ssloy/nixie-clock/hardware/1+3-nixies/Readme.md

# beware of bugs

Some tracks are missing in the PCB layout (the schematics are fine).

The single nixie module lacks two tracks:

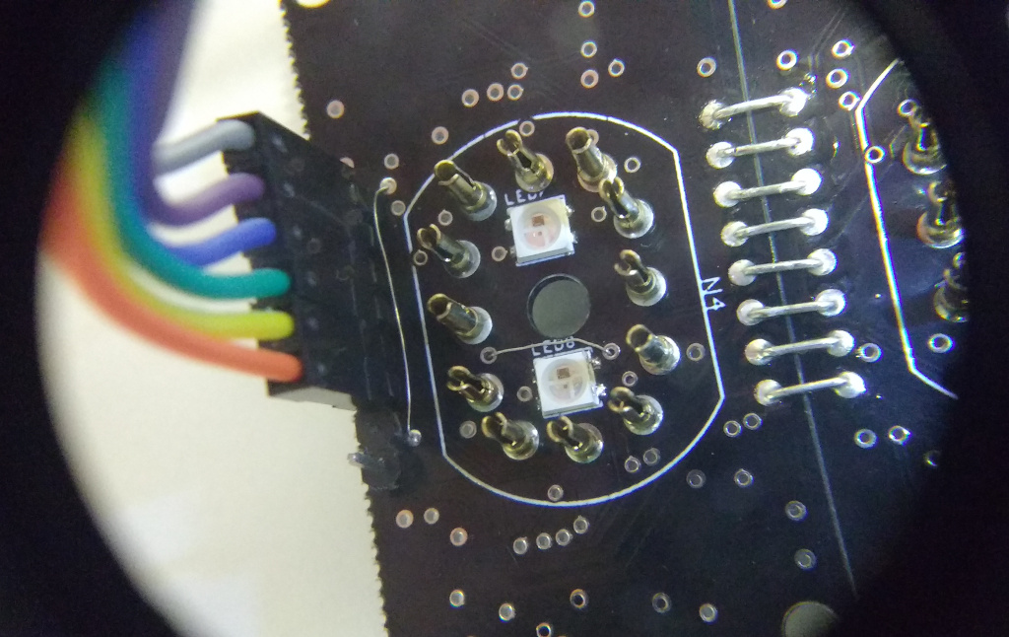
[picture p1: hardware/1+3-nixies/bugfix-1.jpg]


The triple nixie module lacks one track:

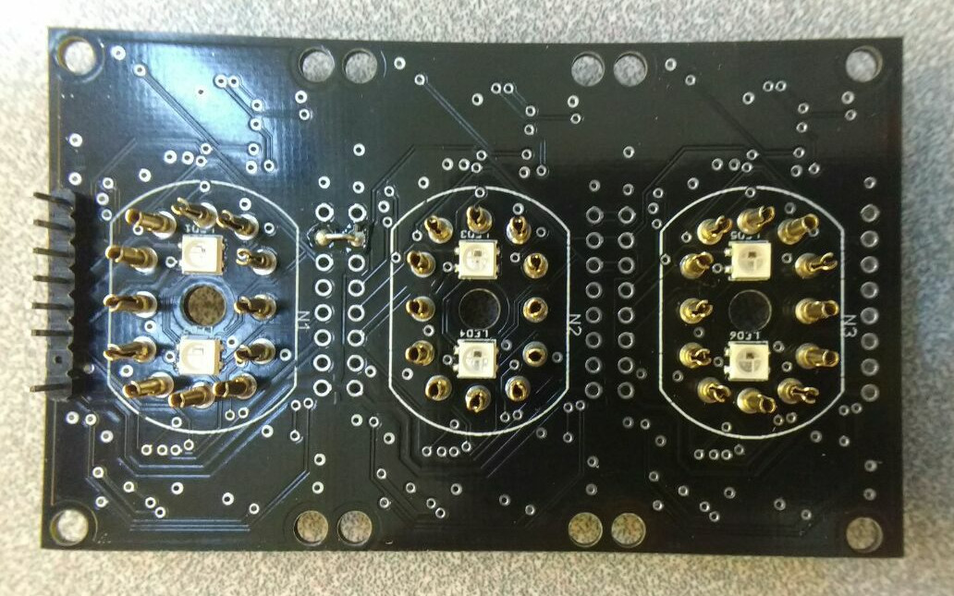
[picture p2: hardware/1+3-nixies/bugfix-3.jpg]
