ssloy/nixie-clock/hardware/ИН12-А(Б).jpg

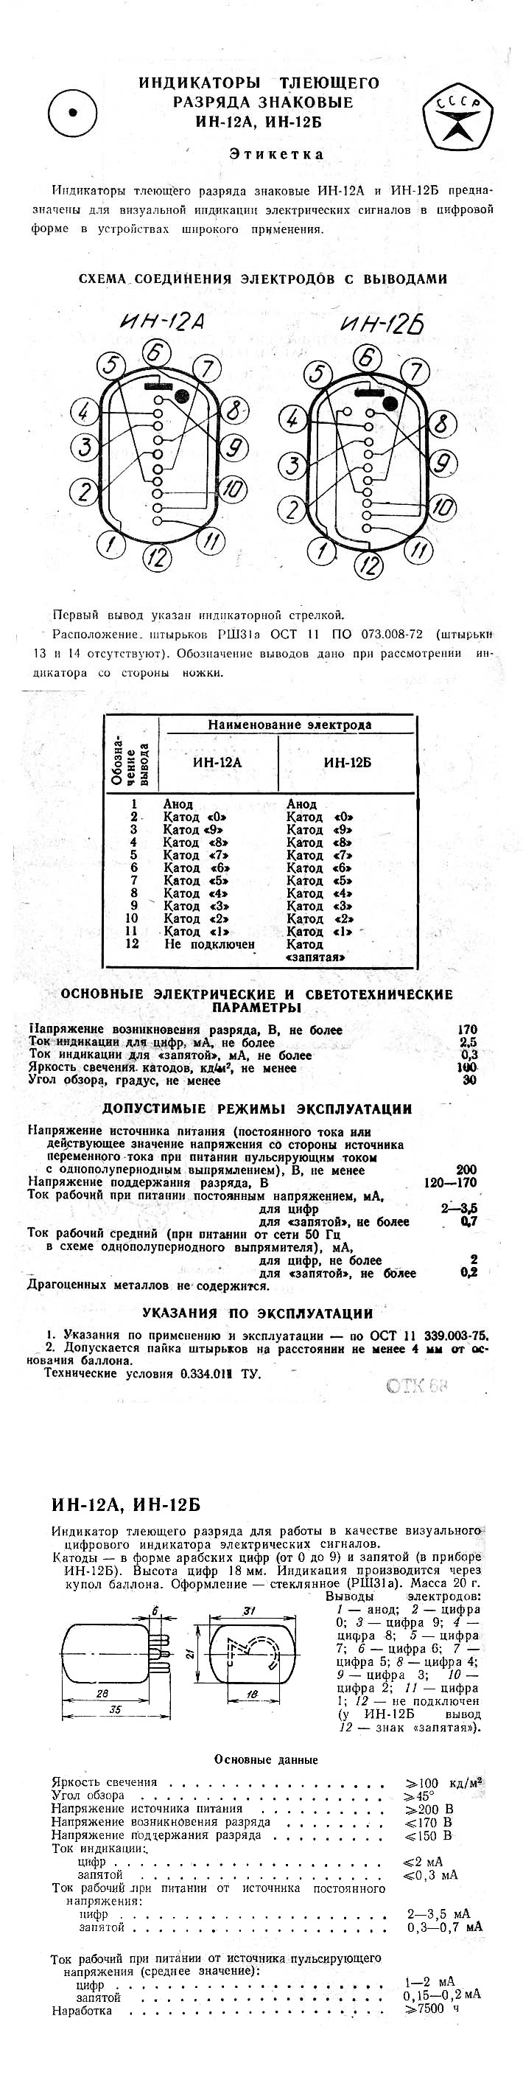
hardware/ИН12-А(Б).jpg
