ssloy/nixie-clock/hardware/ИН-15А(Б).jpg

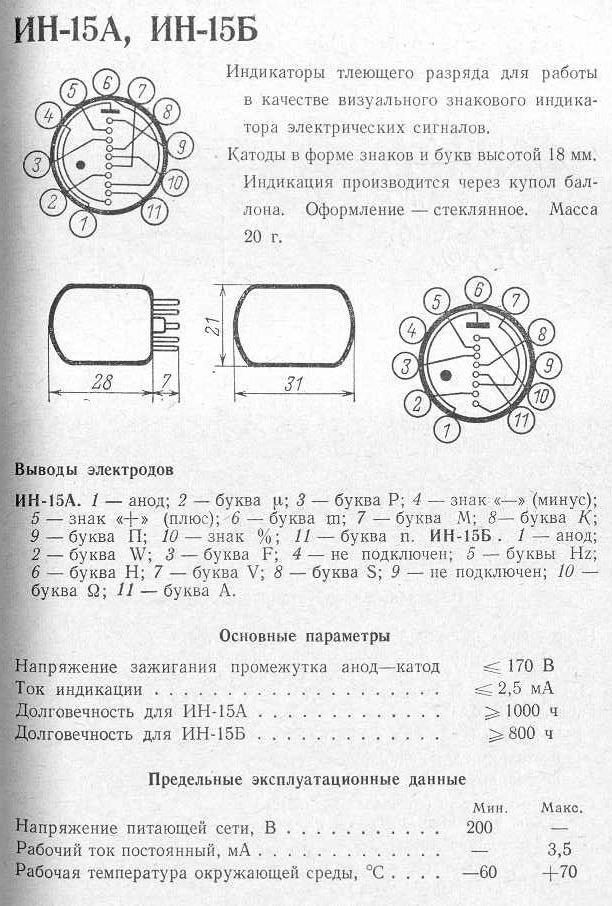
hardware/ИН-15А(Б).jpg
