ssloy/nixie-clock/hardware/ИНС-1.jpg

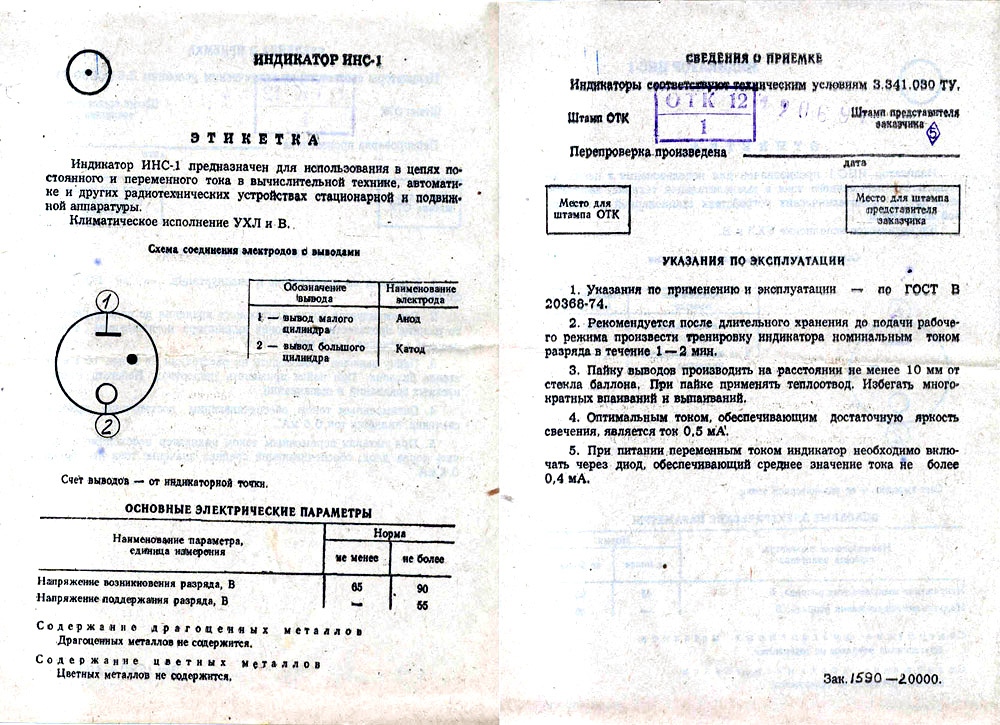
hardware/ИНС-1.jpg
