ssloy/nixie-clock/hardware/HV10W PSU/MC34063HV-02B-SMD.brd

## EAGLE design hardware/HV10W PSU/MC34063HV-02B-SMD.brd (2020-02-29)

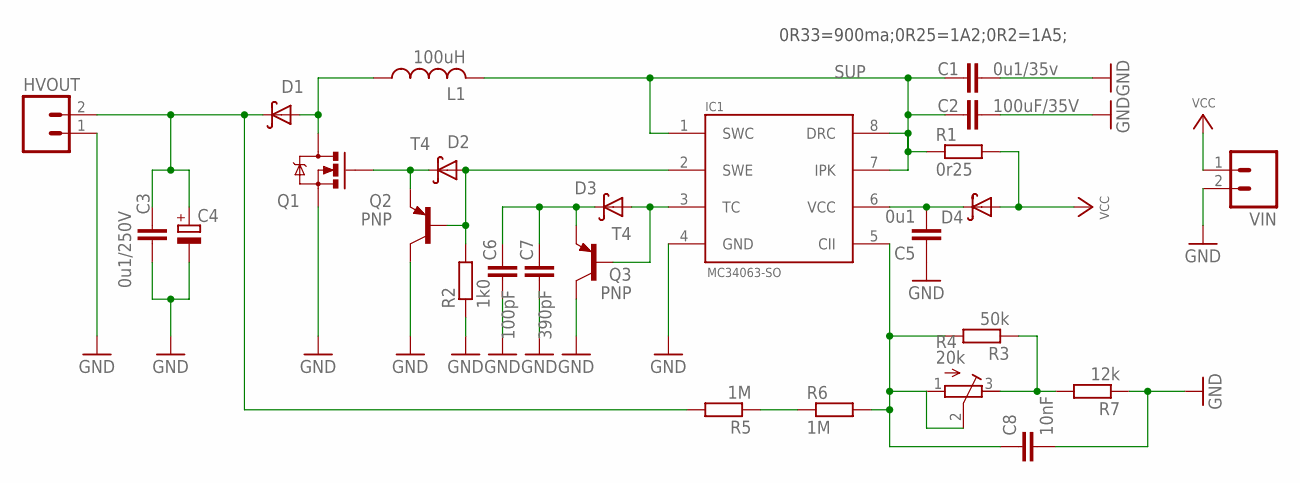
[picture p6: schematic MC34063HV-02B-SMD.sch]

Parts:
C1: 0u1/35v; C1206
C2: 100uF/35V; C1206
C3: 0u1/250V; C1206K
C4: CPOL-EUE5-10.5; E5-10,5
C5: 0u1; C0603
C6: 100pF; C0603
C7: 390pF; C0603
C8: 10nF; C0603
D1, D4: DIODE-SCHOTTKYSMA; SMA-DIODE
D2: T4; SOD123
D3: T4; SOD323-W
HVOUT: M02PTH; 1X02
IC1: MC34063-SO; SO8
L1: 100uH; INDUCTOR11X11
Q1: MOSFET-NCHANNELTO220V-BH2; TO220V-BIGHOLE-V2
Q2, Q3: PNP; SOT23-BEC
R1: 0r25; R1206
R2: 1k0; R0603
R3: 50k; R0603
R4: 20k; RTRIM3296W
R5, R6: 1M; R1206
R7: 12k; R0603
VIN: M02PTH; 1X02

Connections:
GND: C1.2, C2.2, C3.2, C4.-, C5.1, C6.1, C7.1, C8.2, HVOUT.1, IC1.4 (GND), Q1.3 (S), Q2.3 (C), Q3.3 (C), R2.1, R7.1, VIN.2
HVFB: C8.1, IC1.5 (CII), R3.2, R4.1 (A), R4.2 (S), R6.2
unnamed: C6.2, C7.2, D3.C, Q3.2 (E)
unnamed: D2.A, IC1.2 (SWE), Q2.1 (B), R2.2
unnamed: D2.C, Q1.1 (G), Q2.2 (E)
unnamed: C5.2, D4.C, IC1.6 (VCC)
unnamed: C3.1, C4.+, D1.C, HVOUT.2, R5.2
unnamed: D3.A, IC1.3 (TC), Q3.1 (B)
unnamed: R5.1, R6.1
unnamed: R3.1, R4.3 (E), R7.2
SUP: C1.1, C2.1, IC1.1 (SWC), IC1.7 (IPK), IC1.8 (DRC), L1.P$2 (2), R1.1
SW: D1.A, L1.P$1 (1), Q1.2 (D)
VCC: D4.A, R1.2, VIN.1

Notes on the sheet:
0R33=900ma;0R25=1A2;0R2=1A5;

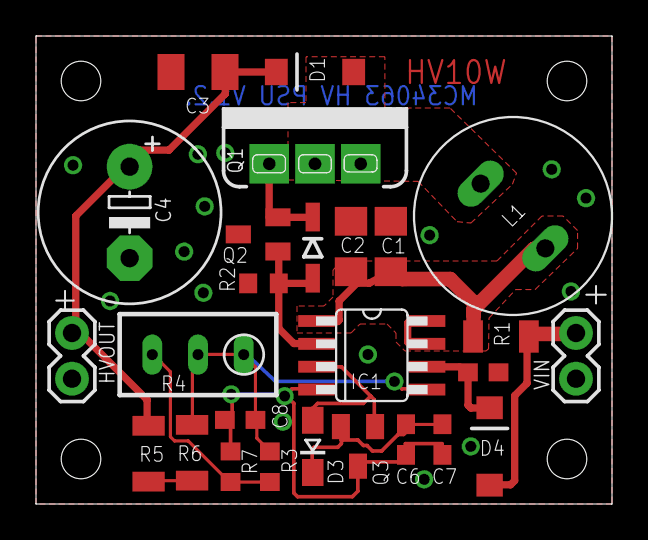
[picture p7: board MC34063HV-02B-SMD.brd from above]

Board: 2 copper layers, 32.0 x 26.0 mm, 27 parts (1 on the bottom side), 13 nets.

Other parts of the board:
U$1: HV03
