ssloy/nixie-clock/hardware/2-nixies/DualNixie.brd

## EAGLE design hardware/2-nixies/DualNixie.brd (2020-02-22)

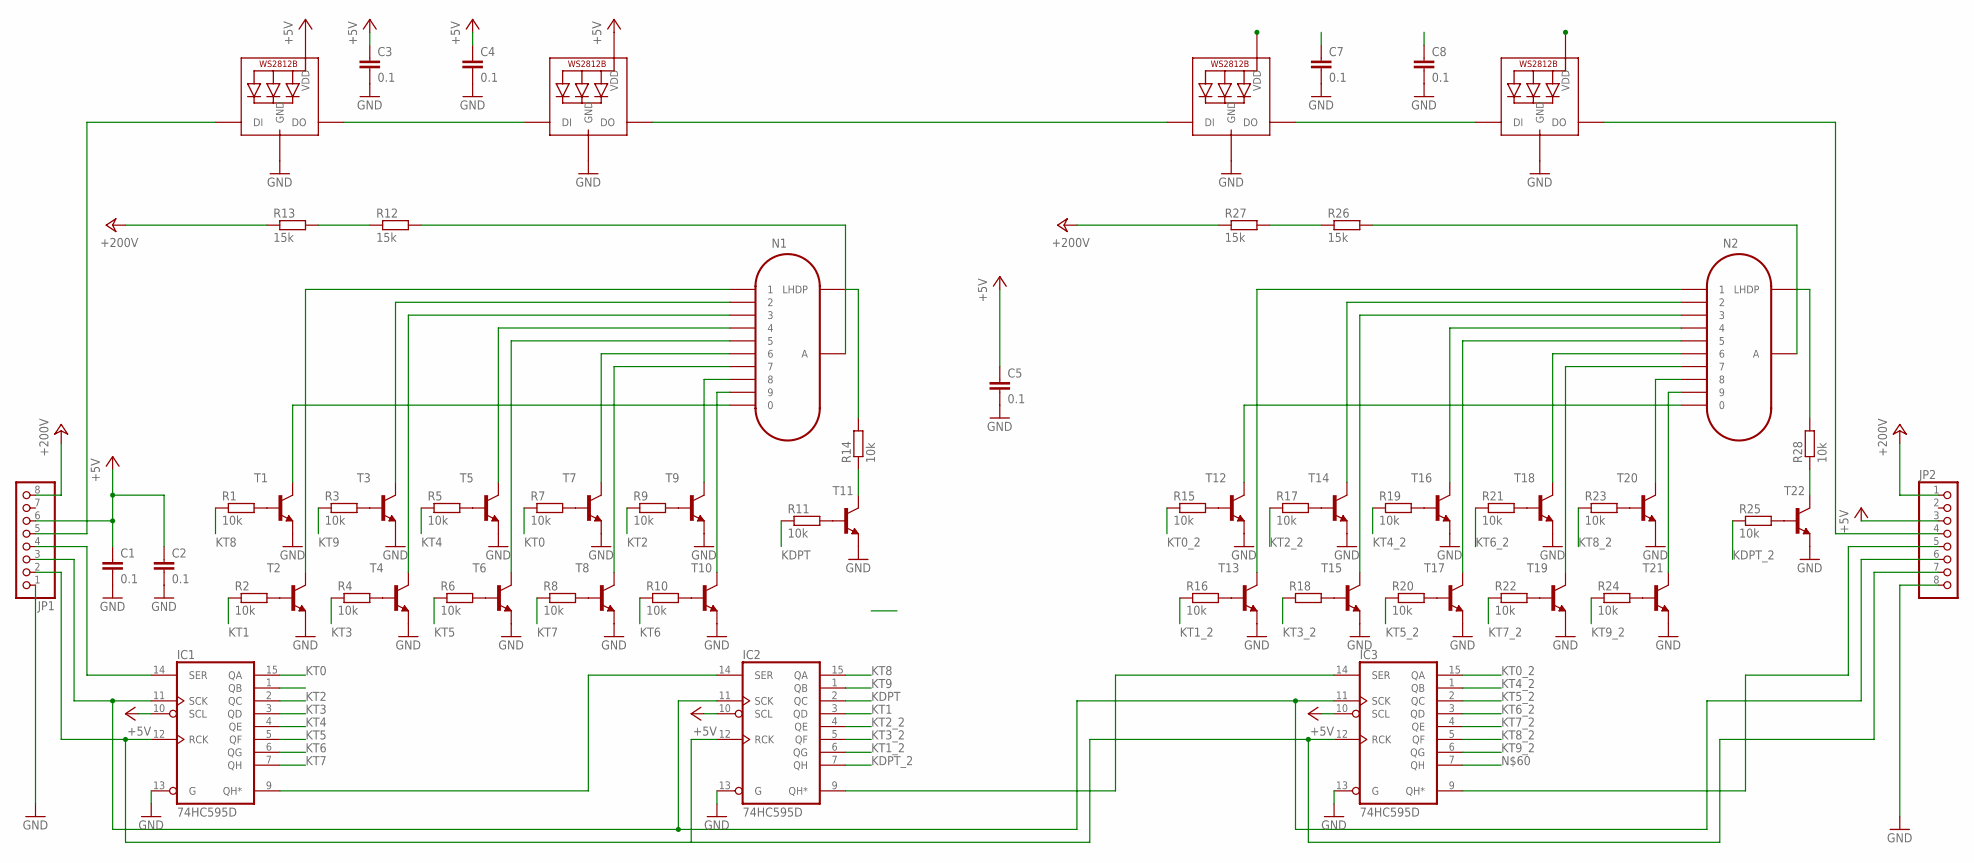
[picture p8: schematic DualNixie.sch]

Parts:
C1, C2, C3, C4, C5, C7, C8: 0.1; C0805
IC1, IC2, IC3: 74HC595D; SO16
JP1, JP2: HEADER-1X8ROUND; 1X08_ROUND
LED1, LED2, LED3, LED4: WS2812B3535; LED3535
N1, N2: IN-12B1.5MM; IN-12-1.5
R1, R2, R3, R4, R5, R6, R7, R8, R9, R10, R11, R14, R15, R16, R17, R18, R19, R20, R21, R22, R23, R24, R25, R28: 10k; R0805
R12, R13, R26, R27: 15k; R0805
T1, T2, T3, T4, T5, T6, T7, T8, T9, T10, T11, T12, T13, T14, T15, T16, T17, T18, T19, T20, T21, T22: MMBTA42LT1-NPN-SOT23-BEC; SOT23-BEC

Connections:
+5V: C1.1, C2.1, C3.1, C4.1, C5.1, C7.1, C8.1, IC1.10 (SCL), IC1.16 (VCC), IC2.10 (SCL), IC2.16 (VCC), IC3.10 (SCL), IC3.16 (VCC), JP1.6, JP2.3, LED1.2 (VDD), LED2.2 (VDD), LED3.2 (VDD), LED4.2 (VDD)
+200V: JP1.8, JP2.1, R13.1, R27.1
ANODE: N1.A, R12.2
ANODE1: N2.A, R26.2
GND: C1.2, C2.2, C3.2, C4.2, C5.2, C7.2, C8.2, IC1.8 (GND), IC1.13 (G), IC2.8 (GND), IC2.13 (G), IC3.8 (GND), IC3.13 (G), JP1.1, JP2.8, LED1.4 (GND), LED2.4 (GND), LED3.4 (GND), LED4.4 (GND), T1.E, T2.E, T3.E, T4.E, T5.E, T6.E, T7.E, T8.E, T9.E, T10.E, T11.E, T12.E, T13.E, T14.E, T15.E, T16.E, T17.E, T18.E, T19.E, T20.E, T21.E, T22.E
K0: N1.0, T1.C
K1: N1.1, T2.C
K2: N1.2, T3.C
K3: N1.3, T4.C
K4: N1.4, T5.C
K5: N1.5, T6.C
K6: N1.6, T7.C
K7: N1.7, T8.C
K8: N1.8, T9.C
K9: N1.9, T10.C
K10: N2.0, T12.C
K11: N2.1, T13.C
K12: N2.2, T14.C
K13: N2.3, T15.C
K14: N2.4, T16.C
K15: N2.5, T17.C
K16: N2.6, T18.C
K17: N2.7, T19.C
K18: N2.8, T20.C
K19: N2.9, T21.C
KDP: N1.LHDP, R14.2
KDP1: N2.LHDP, R28.2
KDPT: IC2.2 (QC), R11.1
KDPT_2: IC2.7 (QH), R25.1
KT0: IC1.15 (QA), R7.1
KT0_2: IC3.15 (QA), R15.1
KT1: IC2.3 (QD), R2.1
KT1_2: IC2.6 (QG), R16.1
KT2: IC1.2 (QC), R9.1
KT2_2: IC2.4 (QE), R17.1
KT3: IC1.3 (QD), R4.1
KT3_2: IC2.5 (QF), R18.1
KT4: IC1.4 (QE), R5.1
KT4_2: IC3.1 (QB), R19.1
KT5: IC1.5 (QF), R6.1
KT5_2: IC3.2 (QC), R20.1
KT6: IC1.6 (QG), R10.1
KT6_2: IC3.3 (QD), R21.1
KT7: IC1.7 (QH), R8.1
KT7_2: IC3.4 (QE), R22.1
KT8: IC2.15 (QA), R1.1
KT8_2: IC3.5 (QF), R23.1
KT9: IC2.1 (QB), R3.1
KT9_2: IC3.6 (QG), R24.1
unnamed: R3.2, T3.B
unnamed: R1.2, T1.B
unnamed: R2.2, T2.B
unnamed: R4.2, T4.B
unnamed: R5.2, T5.B
unnamed: R6.2, T6.B
unnamed: R7.2, T7.B
unnamed: R8.2, T8.B
unnamed: R9.2, T9.B
unnamed: R10.2, T10.B
unnamed: LED1.3 (DO), LED2.1 (DI)
unnamed: JP1.5, LED1.1 (DI)
unnamed: LED2.3 (DO), LED3.1 (DI)
unnamed: R15.2, T12.B
unnamed: R16.2, T13.B
unnamed: R17.2, T14.B
unnamed: R18.2, T15.B
unnamed: R19.2, T16.B
unnamed: R20.2, T17.B
unnamed: R21.2, T18.B
unnamed: R11.2, T11.B
unnamed: IC1.14 (SER), JP1.4
unnamed: R14.1, T11.C
unnamed: R12.1, R13.2
unnamed: IC1.9 (QH*), IC2.14 (SER)
unnamed: IC1.11 (SCK), IC2.11 (SCK), IC3.11 (SCK), JP1.3, JP2.6
unnamed: IC2.9 (QH*), IC3.14 (SER)
unnamed: R22.2, T19.B
unnamed: R23.2, T20.B
unnamed: R24.2, T21.B
unnamed: R25.2, T22.B
unnamed: R28.1, T22.C
unnamed: R26.1, R27.2
unnamed: IC1.12 (RCK), IC2.12 (RCK), IC3.12 (RCK), JP1.2, JP2.7
unnamed: IC3.9 (QH*), JP2.5
unnamed: LED3.3 (DO), LED4.1 (DI)
unnamed: JP2.4, LED4.3 (DO)

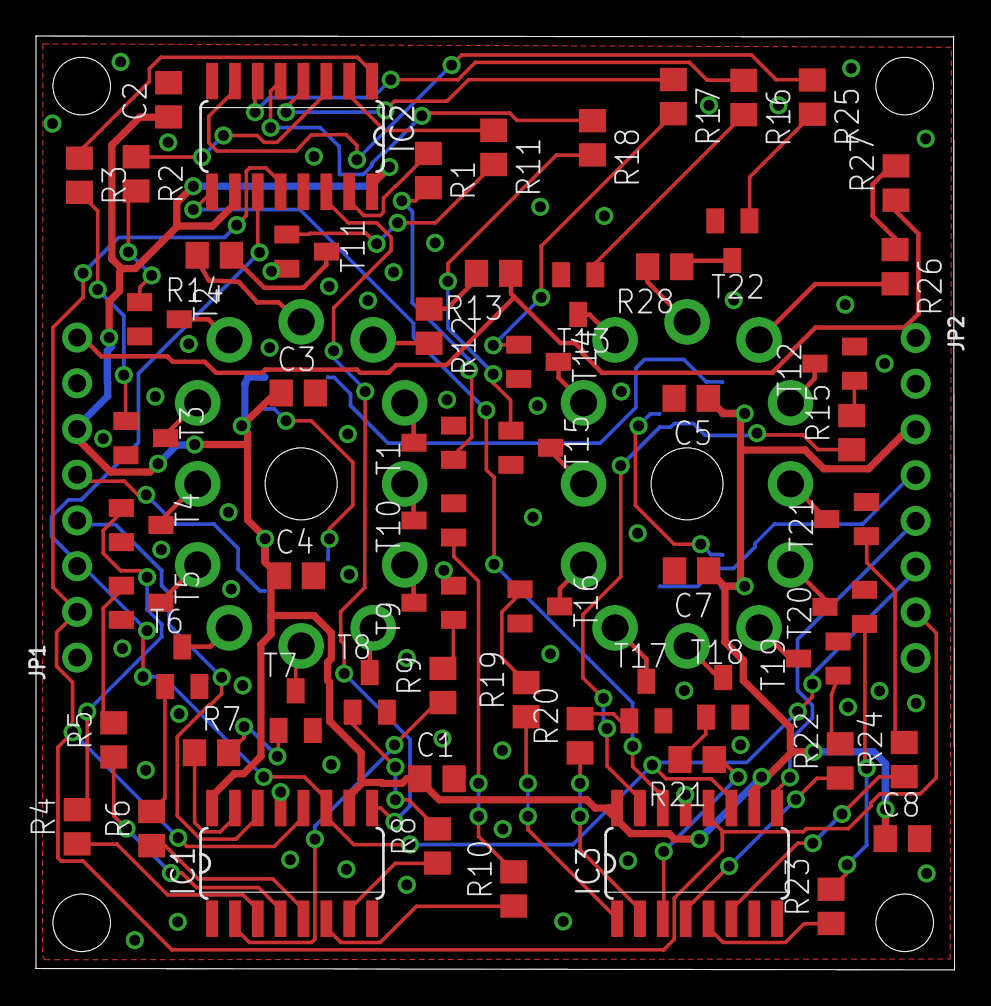
[picture p9: board DualNixie.brd from above]

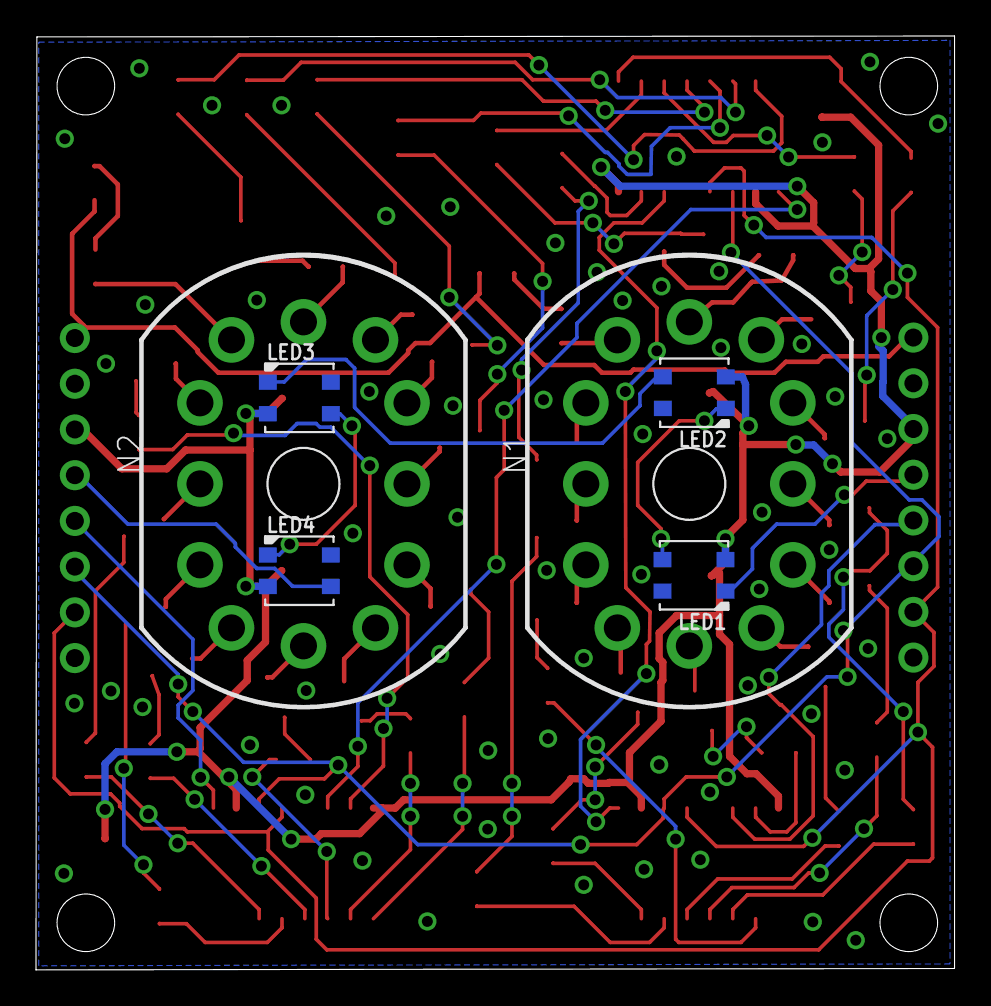
[picture p10: board DualNixie.brd from below]

Board: 2 copper layers, 51.0 x 51.9 mm, 68 parts (6 on the bottom side), 86 nets.
