ssloy/nixie-clock/hardware/1+3-nixies/MultipleNixie.brd

## EAGLE design hardware/1+3-nixies/MultipleNixie.brd (2020-02-29)

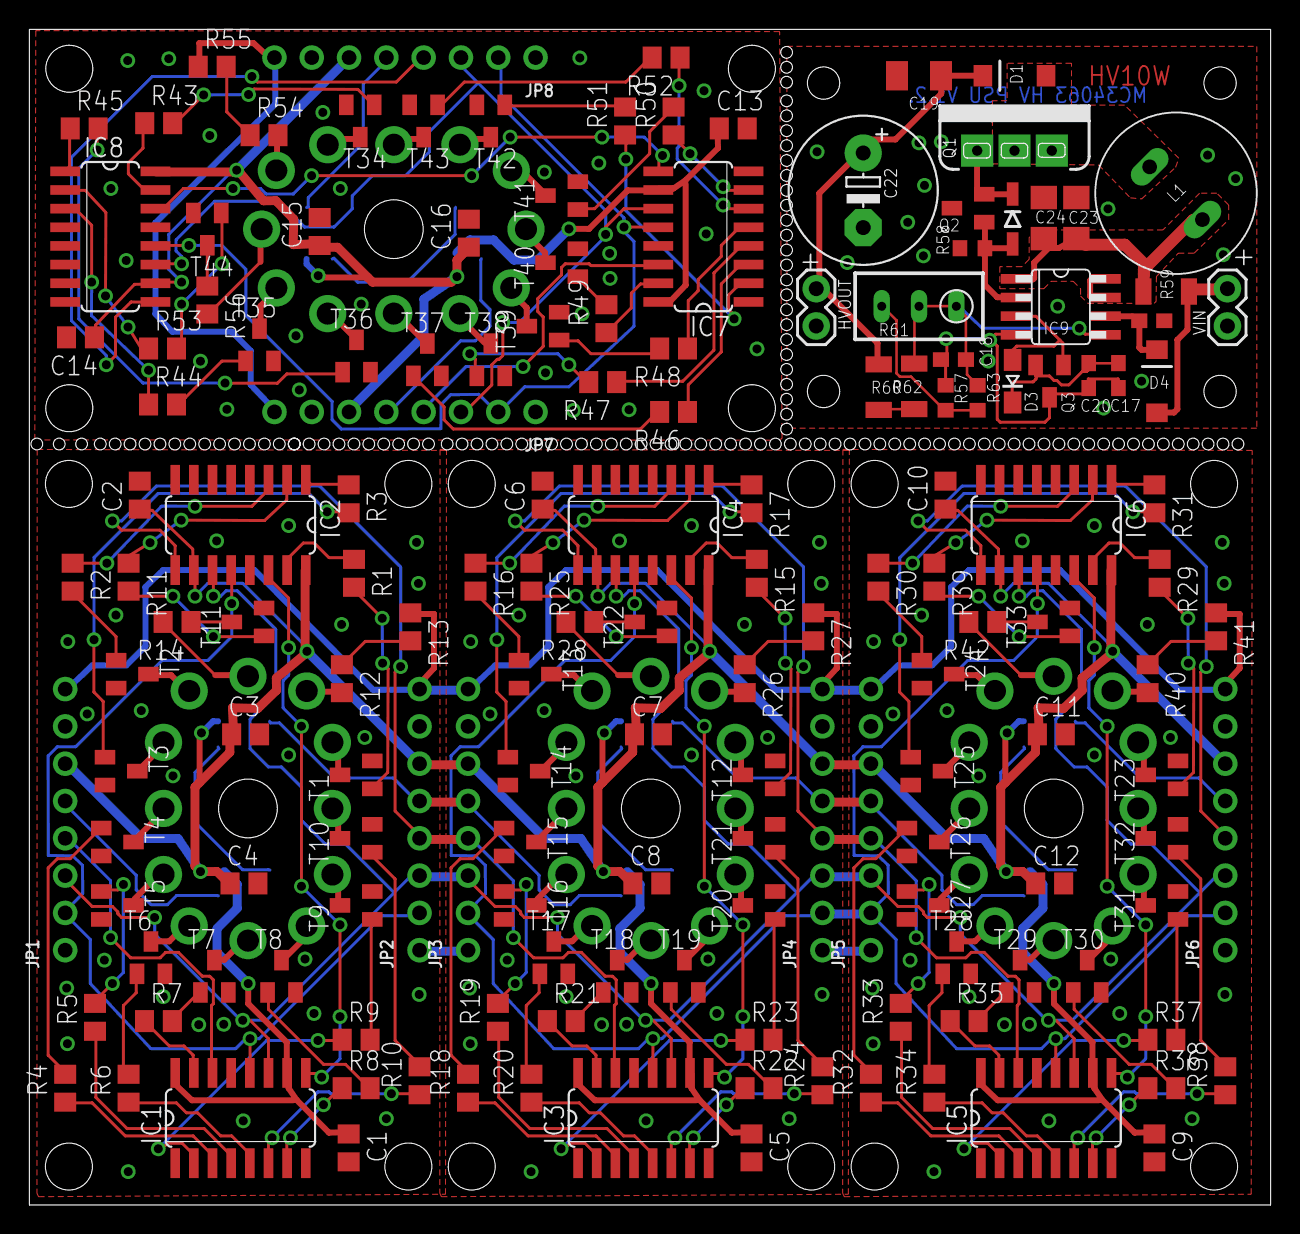
[picture p11: board MultipleNixie.brd from above]

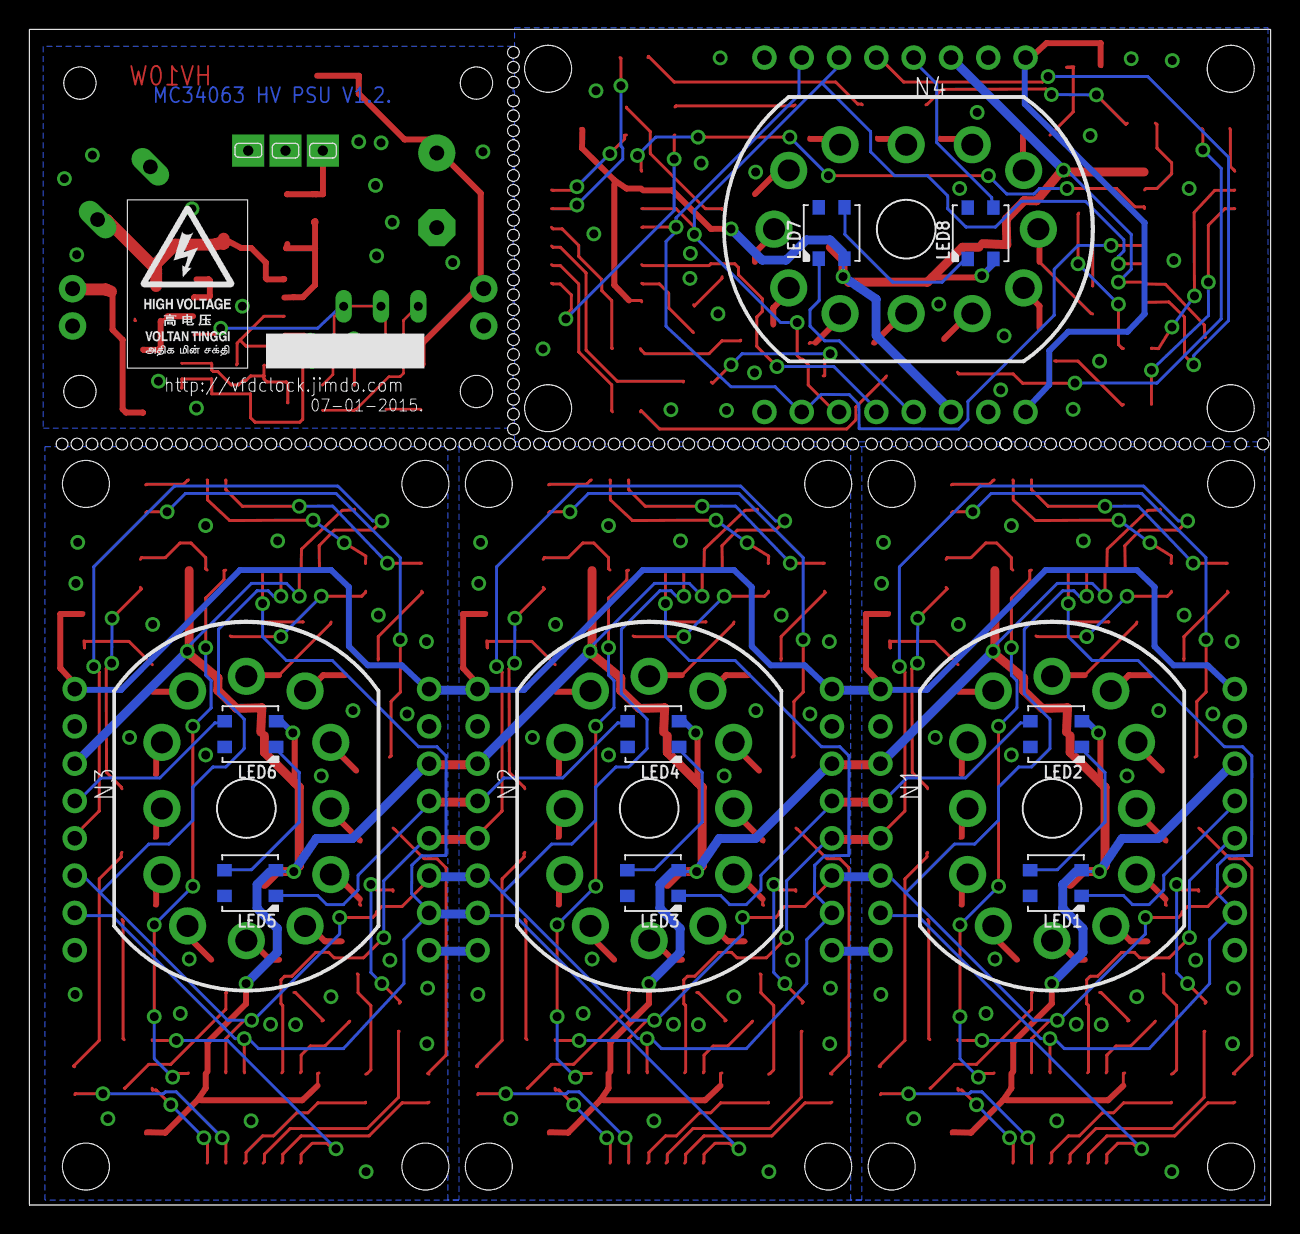
[picture p12: board MultipleNixie.brd from below]

Board: 2 copper layers, 84.5 x 80.1 mm, 171 parts (13 on the bottom side), 199 nets.

Parts:
C1, C2, C3, C4, C5, C6, C7, C8, C9, C10, C11, C12, C13, C14, C15, C16: 0.1; C0805
C17: 390pF; C0603
C18: 10nF; C0603
C19: 0u1/250V; C1206K
C20: 100pF; C0603
C21: 0u1; C0603
C22: E5-10,5
C23: 0u1/35v; C1206
C24: 100uF/35V; C1206
D1: DIODE-SCHOTTKYSMA; SMA-DIODE
D2: T4; SOD123
D3: T4; SOD323-W
D4: SMA-DIODE
HVOUT: 1X02
IC1, IC2, IC3, IC4, IC5, IC6, IC7, IC8: 74HC595D; SO16
IC9: MC34063-SO; SO8
JP1, JP2, JP3, JP4, JP5, JP6, JP7, JP8: 1X08_ROUND
L1: 100uH; INDUCTOR11X11
LED1, LED2, LED3, LED4, LED5, LED6, LED7, LED8: WS2812B3535; LED3535
N1, N2, N3, N4: IN-12B1.5MM; IN-12-1.5
Q1: TO220V-BIGHOLE-V2
Q2, Q3: PNP; SOT23-BEC
R1, R2, R3, R4, R5, R6, R7, R8, R9, R10, R11, R14, R15, R16, R17, R18, R19, R20, R21, R22, R23, R24, R25, R28, R29, R30, R31, R32, R33, R34, R35, R36, R37, R38, R39, R42, R43, R44, R45, R46, R47, R48, R49, R50, R51, R52, R53, R56: 10k; R0805
R12, R13, R26, R27, R40, R41, R54, R55: 15k; R0805
R57: 12k; R0603
R58: 1k0; R0603
R59: 0r25; R1206
R60, R62: 1M; R1206
R61: 20k; RTRIM3296W
R63: 50k; R0603
T1, T2, T3, T4, T5, T6, T7, T8, T9, T10, T11, T12, T13, T14, T15, T16, T17, T18, T19, T20, T21, T22, T23, T24, T25, T26, T27, T28, T29, T30, T31, T32, T33, T34, T35, T36, T37, T38, T39, T40, T41, T42, T43, T44: SOT23-BEC
U$1: HV03
VIN: 1X02

Connections:
+5V: C1.1, C2.1, C3.1, C4.1, IC1.10, IC1.16, IC2.10, IC2.16, JP1.6, JP2.6, LED1.2, LED2.2
+5V1: C5.1, C6.1, C7.1, C8.1, IC3.10, IC3.16, IC4.10, IC4.16, JP3.6, JP4.6, LED3.2, LED4.2
+5V2: C9.1, C10.1, C11.1, C12.1, IC5.10, IC5.16, IC6.10, IC6.16, JP5.6, JP6.6, LED5.2, LED6.2
+5V3: C13.1, C14.1, C15.1, C16.1, IC7.10, IC7.16, IC8.10, IC8.16, JP7.6, JP8.6, LED7.2, LED8.2
+200V: JP1.8, JP2.8, R13.1
+200V1: JP3.8, JP4.8, R27.1
+200V2: JP5.8, JP6.8, R41.1
+200V3: JP7.8, JP8.8, R55.1
ANODE: N1.A, R12.2
ANODE1: N2.A, R26.2
ANODE2: N3.A, R40.2
ANODE3: N4.A, R54.2
GND: C1.2, C2.2, C3.2, C4.2, C5.2, C6.2, C7.2, C8.2, C9.2, C10.2, C11.2, C12.2, IC1.8, IC1.13, IC2.8, IC2.13, IC3.8, IC3.13, IC4.8, IC4.13, IC5.8, IC5.13, IC6.8, IC6.13, JP1.1, JP2.1, JP3.1, JP4.1, JP5.1, JP6.1, LED1.4, LED2.4, LED3.4, LED4.4, LED5.4, LED6.4, T1.E, T2.E, T3.E, T4.E, T5.E, T6.E, T7.E, T8.E, T9.E, T10.E, T11.E, T12.E, T13.E, T14.E, T15.E, T16.E, T17.E, T18.E, T19.E, T20.E, T21.E, T22.E, T23.E, T24.E, T25.E, T26.E, T27.E, T28.E, T29.E, T30.E, T31.E, T32.E, T33.E
GND3: C13.2, C14.2, C15.2, C16.2, IC7.8, IC7.13, IC8.8, IC8.13, JP7.1, JP8.1, LED7.4, LED8.4, T34.E, T35.E, T36.E, T37.E, T38.E, T39.E, T40.E, T41.E, T42.E, T43.E, T44.E
GND4: C17.1, C18.2, C19.2, C20.1, C21.1, C22.-, C23.2, C24.2, HVOUT.1, IC9.4, Q1.3, Q2.3, Q3.3, R57.1, R58.1, VIN.2
HVFB: C18.1, IC9.5, R61.1, R61.2, R62.2, R63.2
K0: N1.0, T1.C
K1: N1.1, T2.C
K2: N1.2, T3.C
K3: N1.3, T4.C
K4: N1.4, T5.C
K5: N1.5, T6.C
K6: N1.6, T7.C
K7: N1.7, T8.C
K8: N1.8, T9.C
K9: N1.9, T10.C
K10: N2.0, T12.C
K11: N2.1, T13.C
K12: N2.2, T14.C
K13: N2.3, T15.C
K14: N2.4, T16.C
K15: N2.5, T17.C
K16: N2.6, T18.C
K17: N2.7, T19.C
K18: N2.8, T20.C
K19: N2.9, T21.C
K20: N3.0, T23.C
K21: N3.1, T24.C
K22: N3.2, T25.C
K23: N3.3, T26.C
K24: N3.4, T27.C
K25: N3.5, T28.C
K26: N3.6, T29.C
K27: N3.7, T30.C
K28: N3.8, T31.C
K29: N3.9, T32.C
K30: N4.0, T34.C
K31: N4.1, T35.C
K32: N4.2, T36.C
K33: N4.3, T37.C
K34: N4.4, T38.C
K35: N4.5, T39.C
K36: N4.6, T40.C
K37: N4.7, T41.C
K38: N4.8, T42.C
K39: N4.9, T43.C
KDP: N1.LHDP, R14.2
KDP1: N2.LHDP, R28.2
KDP2: N3.LHDP, R42.2
KDP3: N4.LHDP, R56.2
KDPT: IC2.2, R11.1
KDPT1: IC4.2, R25.1
KDPT2: IC6.2, R39.1
KDPT3: IC8.2, R53.1
KT0: IC1.15, R7.1
KT1: IC2.3, R2.1
KT2: IC1.2, R9.1
KT3: IC1.3, R4.1
KT4: IC1.4, R5.1
KT5: IC1.5, R6.1
KT6: IC1.6, R10.1
KT7: IC1.7, R8.1
KT8: IC2.15, R1.1
KT9: IC2.1, R3.1
KT10: IC3.15, R21.1
KT11: IC4.3, R16.1
KT12: IC3.2, R23.1
KT13: IC3.3, R18.1
KT14: IC3.4, R19.1
KT15: IC3.5, R20.1
KT16: IC3.6, R24.1
KT17: IC3.7, R22.1
KT18: IC4.15, R15.1
KT19: IC4.1, R17.1
KT20: IC5.15, R35.1
KT21: IC6.3, R30.1
KT22: IC5.2, R37.1
KT23: IC5.3, R32.1
KT24: IC5.4, R33.1
KT25: IC5.5, R34.1
KT26: IC5.6, R38.1
KT27: IC5.7, R36.1
KT28: IC6.15, R29.1
KT29: IC6.1, R31.1
KT30: IC7.15, R49.1
KT31: IC8.3, R44.1
KT32: IC7.2, R51.1
KT33: IC7.3, R46.1
KT34: IC7.4, R47.1
KT35: IC7.5, R48.1
KT36: IC7.6, R52.1
KT37: IC7.7, R50.1
KT38: IC8.15, R43.1
KT39: IC8.1, R45.1
unnamed: R3.2, T3.B
unnamed: R1.2, T1.B
unnamed: R2.2, T2.B
unnamed: R4.2, T4.B
unnamed: R5.2, T5.B
unnamed: R6.2, T6.B
unnamed: R7.2, T7.B
unnamed: R8.2, T8.B
unnamed: R9.2, T9.B
unnamed: R10.2, T10.B
unnamed: LED1.3, LED2.1
unnamed: JP1.5, LED1.1
unnamed: JP2.5, LED2.3
unnamed: R15.2, T12.B
unnamed: R16.2, T13.B
unnamed: R17.2, T14.B
unnamed: R18.2, T15.B
unnamed: R19.2, T16.B
unnamed: R20.2, T17.B
unnamed: R21.2, T18.B
unnamed: R11.2, T11.B
unnamed: IC1.14, JP1.4
unnamed: R14.1, T11.C
unnamed: R12.1, R13.2
unnamed: IC1.9, IC2.14
unnamed: IC1.11, IC2.11, JP1.3, JP2.3
unnamed: IC1.12, IC2.12, JP1.2, JP2.2
unnamed: IC2.9, JP2.4
unnamed: R22.2, T19.B
unnamed: R23.2, T20.B
unnamed: R24.2, T21.B
unnamed: R25.2, T22.B
unnamed: R28.1, T22.C
unnamed: R26.1, R27.2
unnamed: IC3.14, JP3.4
unnamed: IC3.9, IC4.14
unnamed: IC3.11, IC4.11, JP3.3, JP4.3
unnamed: IC3.12, IC4.12, JP3.2, JP4.2
unnamed: IC4.9, JP4.4
unnamed: LED3.3, LED4.1
unnamed: JP3.5, LED3.1
unnamed: JP4.5, LED4.3
unnamed: R29.2, T23.B
unnamed: R30.2, T24.B
unnamed: R31.2, T25.B
unnamed: R32.2, T26.B
unnamed: R33.2, T27.B
unnamed: R34.2, T28.B
unnamed: R35.2, T29.B
unnamed: R36.2, T30.B
unnamed: R37.2, T31.B
unnamed: R38.2, T32.B
unnamed: R39.2, T33.B
unnamed: R42.1, T33.C
unnamed: R40.1, R41.2
unnamed: IC5.14, JP5.4
unnamed: IC5.9, IC6.14
unnamed: IC5.11, IC6.11, JP5.3, JP6.3
unnamed: IC5.12, IC6.12, JP5.2, JP6.2
unnamed: IC6.9, JP6.4
unnamed: LED5.3, LED6.1
unnamed: JP5.5, LED5.1
unnamed: JP6.5, LED6.3
unnamed: R43.2, T34.B
unnamed: R44.2, T35.B
unnamed: R45.2, T36.B
unnamed: R46.2, T37.B
unnamed: R47.2, T38.B
unnamed: R48.2, T39.B
unnamed: R49.2, T40.B
unnamed: R50.2, T41.B
unnamed: R51.2, T42.B
unnamed: R52.2, T43.B
unnamed: R53.2, T44.B
unnamed: R56.1, T44.C
unnamed: R54.1, R55.2
unnamed: IC7.14, JP7.4
unnamed: IC7.9, IC8.14
unnamed: IC7.11, IC8.11, JP7.3, JP8.3
unnamed: IC7.12, IC8.12, JP7.2, JP8.2
unnamed: IC8.9, JP8.4
unnamed: LED7.3, LED8.1
unnamed: JP7.5, LED7.1
unnamed: JP8.5, LED8.3
unnamed: C17.2, C20.2, D3.C, Q3.2
unnamed: D2.A, IC9.2, Q2.1, R58.2
unnamed: D2.C, Q1.1, Q2.2
unnamed: C19.1, C22.+, D1.C, HVOUT.2, R60.2
unnamed: R60.1, R62.1
unnamed: R57.2, R61.3, R63.1
unnamed: C21.2, D4.C, IC9.6
unnamed: D3.A, IC9.3, Q3.1
SUP: C23.1, C24.1, IC9.1, IC9.7, IC9.8, L1.P$2, R59.1
SW: D1.A, L1.P$1, Q1.2
VCC: D4.A, R59.2, VIN.1
