ssloy/nixie-clock/(commit log)

2020-02-22 nixie import
    [DualNixie.brd, DualNixie.sch]
2020-02-29 ИН-12, ИН-15, ИНС-1 data sheets
2020-02-29 EAGLE + gerber files
    [DualNixie.brd, DualNixie.sch, MC34063HV-02B-SMD.brd, MC34063HV-02B-SMD.sch, MultipleNixie.brd, SingleNixie.brd, SingleNixie.sch]
